tokoro10g/micromouse-vert/hardware/Mechanical/[Export]Digimode.stl

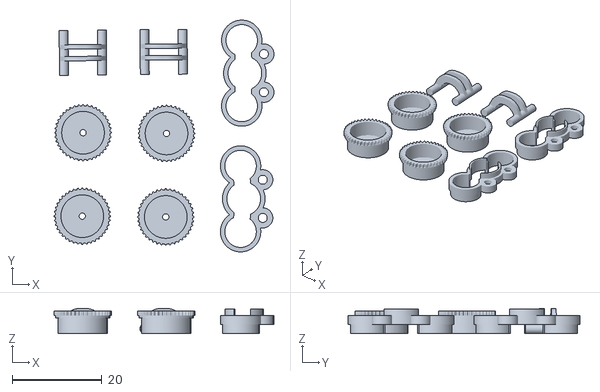
[picture p4: CAD file, 2017-10-23]
hardware/Mechanical/[Export]Digimode.stl
49.0 x 51.6 x 5.58
