tokoro10g/micromouse-vert/hardware/PCB/outline/Vert_Board.dxf

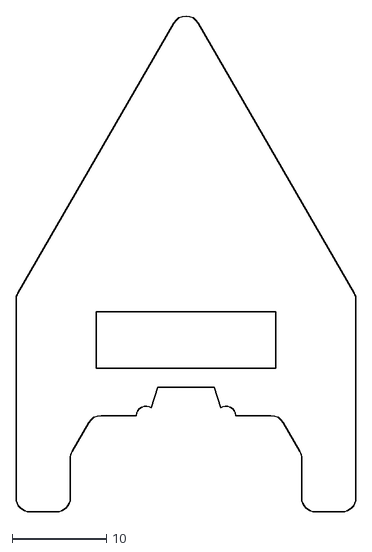
[picture p5: CAD file, 2017-10-23]
hardware/PCB/outline/Vert_Board.dxf
36.0 x 52.5
