tokoro10g/micromouse-vert/hardware/Mechanical/[Export]DMM.stl

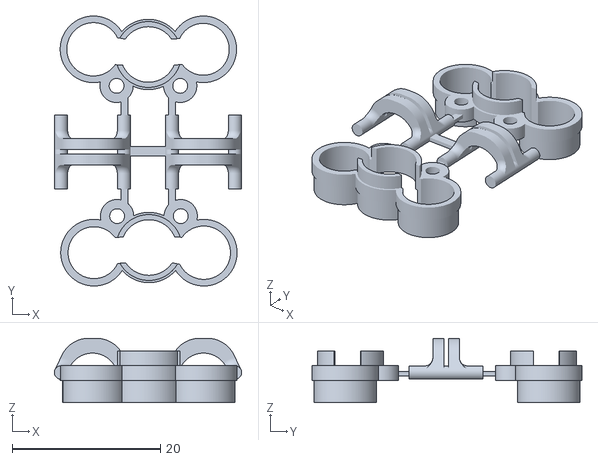
[picture p6: CAD file, 2017-10-23]
hardware/Mechanical/[Export]DMM.stl
25.3 x 36.5 x 8.70
