tokoro10g/micromouse-vert/(threads)

Thread 1 (2017-11-14):

正常に復帰できないパターンがある

tokoro10g, 2017-11-14:
6cc9f4a 時点での既知の不具合

* `Agent::searchCandidateNode`で探したノードに壁があり，かつそれが最後のCandidateNodeである場合に無限ループに陥って戻ってこない
* フェイルセーフ以外の理由(スタートからゴールまでの経路が存在しないときなど)で停止したとき，`Machine::isActivated_`の状態が解除されず，メニューに戻らない
* `Agent::searchCandidateNode`による未探索壁のチェック終了後にフェイルセーフがかかると，`backupMaze`が正常に機能しないことがある
* 探索が正常に終了しなかった後の`fastRunMode`終了後に`backupMaze`が正常に機能しないことがある

Closed 2017-11-16.
