tokoro10g/micromouse-vert/hardware/PCB/Vert_Board_rev3.kicad_pcb

## KiCad design hardware/PCB/Vert_Board_rev3.kicad_pcb (2017-10-23)

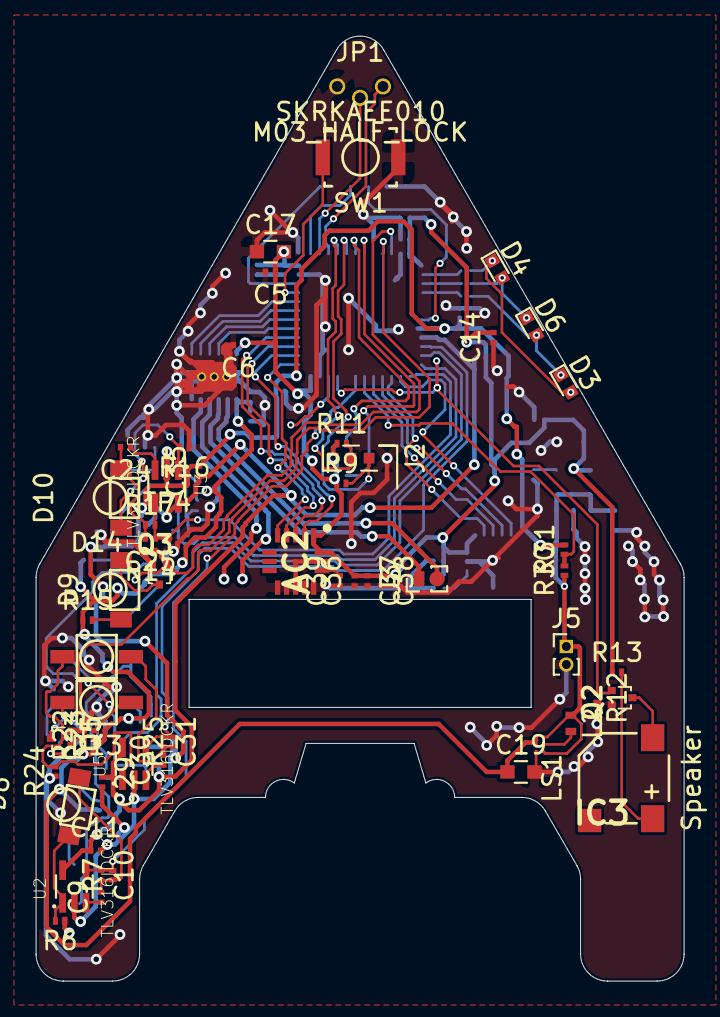
[picture p7: board Vert_Board_rev3.kicad_pcb from above]

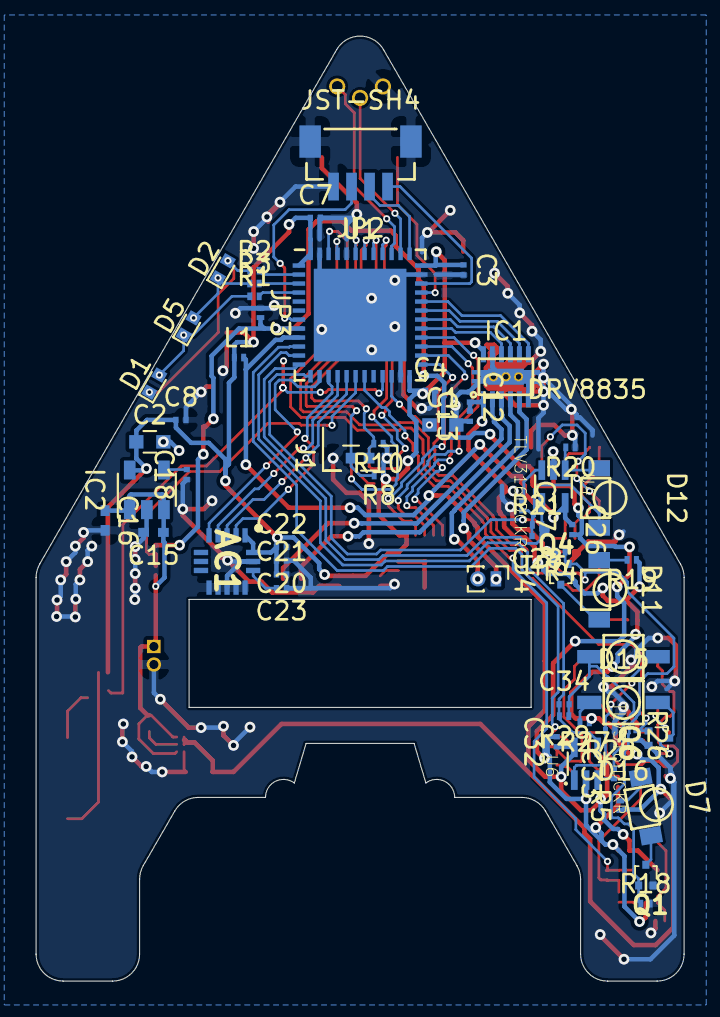
[picture p8: board Vert_Board_rev3.kicad_pcb from below]

Board: 4 copper layers, 36.0 x 52.5 mm, 117 parts (59 on the bottom side), 79 nets.

Parts:
AC1, AC2: ICM-20602; QFN50P300X300X75-16N
C1, C2, C19: 4.7u; C_0603
C3, C4, C5, C6, C7, C8, C11, C12, C14, C21, C23, C26, C29, C32, C35, C37, C39: 0.1u; C_0201_NoSilk
C9, C24, C27, C30, C33: 0.01u(NC); C_0201_NoSilk
C10, C25, C28, C31, C34: 22p; C_0201_NoSilk
C13: 22u; C_0201_NoSilk
C15: 2.2u; C_0402_NoSilk
C16: 1u; C_0402_NoSilk
C17: 10u; C_0603
C18, C20, C36: 0.01u; C_0201_NoSilk
C22, C38: 2.2u; C_0201_NoSilk
D1, D2, D3, D4, D5, D6: LED; LED_0402
D7, D9, D11: VSMB294008G; VSMB2943SL
D8, D10, D12: VEMD2020X01; VEMD2023SL
D13, D15: VSMB294008G
D14, D16: VEMD2020X01; VEMD2020
IC1: DRV8835
IC2: TAR5SB33; SOT-23-5
IC3: TPS6124x; BGA6C40P2X3_125X85X63
J1, J2: Conn_01x04; Pin_Header_Straight_1x04_Pitch1.00mm_SMD_Pin1Right
J3, J4, J5: Conn_01x02; Pin_Header_Straight_1x02_Pitch1.00mm
JP1: M03_HALF_LOCK
JP2: JST-SH4
JP3: Jumper_NC_Small; R_0201_NoSilk
L1: 10Z; R_0201_NoSilk
L2: 1u; R_0402_NoSilk
LS1: Speaker; SMT-0540-S-R
Q1, Q3, Q4, Q5, Q6: NTK3134NT1G; SOT-723
Q2: Q_NMOS_GSD; SOT-723
R1, R2, R3: 470; R_0201_NoSilk
R4, R8, R9, R10, R11, R12, R14, R18, R22, R26: 47k; R_0201_NoSilk
R5, R15, R19, R23, R27: 20; R_0201_NoSilk
R6, R16, R20, R24, R28, R30, R31: 500k; R_0201_NoSilk
R7, R17, R21, R25, R29: 1M; R_0201_NoSilk
R13: 22; R_0201_NoSilk
SW1: SKRKAEE010; ALPS-SKRK
TP4, TP6: TEST; Measurement_Point_Round-SMD-Pad_Small
U1: STM32F411CEUx; QFN-48-1EP_7x7mm_Pitch0.5mm
U2, U3, U4, U5, U6: TLV316IDCKR; SOT65P210X110-5N

Connections:
+5V: C12.2, C13.2, C19.1, IC1.1, IC3.B2, IC3.C2, R5.1, R15.1, R19.1, R23.1, R27.1
+BATT: C15.1, C16.1, IC2.1, IC2.3, IC3.A1, IC3.C1, J5.1, L2.1, R30.1
/Buzzer/BUZZER: Q2.1, R12.1, U1.21
/MCU/IMU1_MISO: AC1.4, U1.16
/MCU/IMU1_MOSI: AC1.3, U1.17
/MCU/IMU1_NSS: AC1.5, U1.14
/MCU/IMU1_SCK: AC1.2, U1.15
/MCU/IMU2_MISO: AC2.4, U1.27
/MCU/IMU2_MOSI: AC2.3, U1.28
/MCU/IMU2_NSS: AC2.5, U1.25
/MCU/IMU2_SCK: AC2.2, U1.26
/MCU/IRLED1: Q5.1, Q6.1, R22.1, R26.1, U1.45
/MCU/IRLED2: Q1.1, Q3.1, Q4.1, R4.1, R14.1, R18.1, U1.46
/MCU/MOTOR_LA: IC1.8, U1.31
/MCU/MOTOR_LB: IC1.7, U1.32
/MCU/MOTOR_RA: IC1.10, U1.29
/MCU/MOTOR_RB: IC1.9, U1.30
/MCU/NRST: JP2.2, U1.7
/MCU/SWCLK: JP2.3, U1.37
/MCU/SWDIO: JP2.4, U1.34
/MCU/UI_LED1: R2.2, U1.2
/MCU/UI_LED2: R3.2, U1.3
/MCU/UI_LED3: R1.2, U1.4
/MCU/UI_SWITCH: SW1.1, U1.33
/MCU/USART_MISO: JP1.1, U1.39
/MCU/USART_MOSI: JP1.2, U1.38
/Motor_L/ENCLA: J2.3, R11.2, U1.40
/Motor_L/ENCLB: J2.2, R9.2, U1.41
/Motor_L/ENCRA: J1.2, R8.2, U1.43
/Motor_L/ENCRB: J1.3, R10.2, U1.42
/OpticalSensor_FRONT/IR_SENS: C10.1, R7.2, U1.19, U2.4
/OpticalSensor_IRLB/IR_SENS: C25.1, R17.2, TP4.1, U1.13, U3.4
/OpticalSensor_IRLF/IR_SENS: C34.1, R29.2, U1.11, U6.4
/OpticalSensor_IRRB/IR_SENS: C28.1, R21.2, TP6.1, U1.12, U4.4
/OpticalSensor_IRRF/IR_SENS: C31.1, R25.2, U1.10, U5.4
GND: AC1.9, AC1.10, AC1.11, AC1.12, AC1.13, AC1.15, AC2.9, AC2.10, AC2.11, AC2.12, AC2.13, AC2.15, C1.2, C2.2, C3.2, C4.2, C5.2, C6.2, C7.2, C8.2, C12.1, C13.1, C14.1, C15.2, C16.2, C17.1, C18.1, C19.2, C20.1, C21.2, C22.2, C23.1, C36.1, C37.2, C38.2, C39.1, IC1.0, IC1.6, IC1.11, IC2.2, IC3.A2, J1.1, J2.1, J5.2, JP1.3, JP2.0, JP2.1, JP3.1, Q1.2, Q2.2, Q3.2, Q4.2, Q5.2, Q6.2, R4.2, R6.1, R12.2, R14.2, R16.1, R18.2, R20.1, R22.2, R24.1, R26.2, R28.1, SW1.2, U1.23, U1.35, U1.44, U1.47, U1.49
GNDA: C11.2, C26.2, C29.2, C32.2, C35.2, JP3.2, R31.2, U1.8, U2.2, U3.2, U4.2, U5.2, U6.2
unnamed: AC1.14, C23.2
unnamed: AC2.14, C39.2
unnamed: C1.1, U1.22
unnamed: C9.1, U2.3
unnamed: C9.2, C10.2, D8.2, R7.1
unnamed: C18.2, IC2.4
unnamed: C24.1, U3.3
unnamed: C24.2, C25.2, D10.2, R17.1
unnamed: C27.1, U4.3
unnamed: C27.2, C28.2, D12.2, R21.1
unnamed: C30.1, U5.3
unnamed: C30.2, C31.2, D14.2, R25.1
unnamed: C33.1, U6.3
unnamed: C33.2, C34.2, D16.2, R29.1
unnamed: D1.1, D2.2, D3.2, D4.1, R2.1
unnamed: D1.2, D3.1, D5.1, D6.2, R1.1
unnamed: D2.1, D4.2, D5.2, D6.1, R3.1
unnamed: D7.1, Q1.3
unnamed: D7.2, R5.2
unnamed: D8.1, R6.2, U2.1
unnamed: D9.1, Q3.3
unnamed: D9.2, R15.2
unnamed: D10.1, R16.2, U3.1
unnamed: D11.1, Q4.3
unnamed: D11.2, R19.2
unnamed: D12.1, R20.2, U4.1
unnamed: D13.1, Q5.3
unnamed: D13.2, R23.2
unnamed: D14.1, R24.2, U5.1
unnamed: D15.1, Q6.3
unnamed: D15.2, R27.2
unnamed: D16.1, R28.2, U6.1
unnamed: IC1.2, J3.2
unnamed: IC1.3, J3.1
unnamed: IC1.4, J4.2
unnamed: IC1.5, J4.1
unnamed: IC3.B1, L2.2
unnamed: LS1.1, R13.2
unnamed: LS1.2, Q2.3
unnamed: R30.2, R31.1, U1.18
VDD: AC1.1, AC1.16, AC2.1, AC2.16, C2.1, C3.1, C4.1, C5.1, C6.1, C7.1, C8.1, C14.2, C17.2, C20.2, C21.1, C22.1, C36.2, C37.1, C38.1, IC1.12, IC2.5, J1.4, J2.4, L1.1, R8.1, R9.1, R10.1, R11.1, R13.1, U1.1, U1.24, U1.36, U1.48
VDDA: C11.1, C26.1, C29.1, C32.1, C35.1, L1.2, U1.9, U2.5, U3.5, U4.5, U5.5, U6.5
