tokoro10g/micromouse-vert/src/vert_firmware/autogen/vert_firmware.ioc

Mcu.UserName=STM32F411CEUx
PA0-WKUP.Signal=ADCx_IN0
PA1.Signal=ADCx_IN1
PA10.GPIO_Label=MOTOR_LA
PA10.Signal=S_TIM1_CH3
PA11.GPIO_Label=MOTOR_LB
PA11.Signal=S_TIM1_CH4
PA12.GPIO_Label=GPIO_IN_Button
PA12.Signal=GPIO_Input
PA13.Signal=SYS_JTMS-SWDIO
PA14.Signal=SYS_JTCK-SWCLK
PA15.Signal=USART1_TX
PA2.Signal=ADCx_IN2
PA3.Signal=ADCx_IN3
PA4.Signal=SPI1_NSS
PA5.Signal=SPI1_SCK
PA6.Signal=SPI1_MISO
PA7.Signal=SPI1_MOSI
PA8.GPIO_Label=MOTOR_RA
PA8.Signal=S_TIM1_CH1
PA9.GPIO_Label=MOTOR_RB
PA9.Signal=S_TIM1_CH2
PB0.Signal=ADCx_IN8
PB1.Signal=ADCx_IN9
PB10.GPIO_Label=TIM2_CH3_Buzzer
PB10.Signal=S_TIM2_CH3
PB12.Signal=SPI2_NSS
PB13.Signal=SPI2_SCK
PB14.Signal=SPI2_MISO
PB15.Signal=SPI2_MOSI
PB3.Signal=USART1_RX
PB4.Signal=S_TIM3_CH1
PB5.Signal=S_TIM3_CH2
PB6.Signal=S_TIM4_CH1
PB7.Signal=S_TIM4_CH2
PB8.GPIO_Label=IRLED1
PB8.Signal=S_TIM10_CH1
PB9.GPIO_Label=IRLED2
PB9.Signal=S_TIM11_CH1
PC13-ANTI_TAMP.Signal=GPIO_Output
PC14-OSC32_IN.Signal=GPIO_Output
PC15-OSC32_OUT.Signal=GPIO_Output
