tokoro10g/micromouse-vert/src/vert_firmware/autogen/Inc/main.h

#define TIM2_CH3_Buzzer_Pin GPIO_PIN_10
#define TIM2_CH3_Buzzer_GPIO_Port GPIOB
#define MOTOR_RA_Pin GPIO_PIN_8
#define MOTOR_RA_GPIO_Port GPIOA
#define MOTOR_RB_Pin GPIO_PIN_9
#define MOTOR_RB_GPIO_Port GPIOA
#define MOTOR_LA_Pin GPIO_PIN_10
#define MOTOR_LA_GPIO_Port GPIOA
#define MOTOR_LB_Pin GPIO_PIN_11
#define MOTOR_LB_GPIO_Port GPIOA
#define GPIO_IN_Button_Pin GPIO_PIN_12
#define GPIO_IN_Button_GPIO_Port GPIOA
#define IRLED1_Pin GPIO_PIN_8
#define IRLED1_GPIO_Port GPIOB
#define IRLED2_Pin GPIO_PIN_9
#define IRLED2_GPIO_Port GPIOB
