tokoro10g/micromouse-vert/src/mymath/mymath.h

#pragma once

namespace MyMath {
	const float PI = 3.1415927f;
	const uint32_t FAST_MATH_TABLE_SIZE = 512;

	/**   
	 * \par    
	 * Example code for the generation of the floating-point sine table:
	 * <pre>
	 * tableSize = 512;    
	 * for(n = 0; n < (tableSize + 1); n++)    
	 * {    
	 *	sinTable[n]=sin(2*pi*n/tableSize);    
	 * }</pre>    
	 * \par    
	 * where pi value is  3.14159265358979    
	 */

	static const float sinTable_f32[513] = {
		0.00000000f, 0.01227154f, 0.02454123f, 0.03680722f, 0.04906767f, 0.06132074f,
		0.07356456f, 0.08579731f, 0.09801714f, 0.11022221f, 0.12241068f, 0.13458071f,
		0.14673047f, 0.15885814f, 0.17096189f, 0.18303989f, 0.19509032f, 0.20711138f,
		0.21910124f, 0.23105811f, 0.24298018f, 0.25486566f, 0.26671276f, 0.27851969f,
		0.29028468f, 0.30200595f, 0.31368174f, 0.32531029f, 0.33688985f, 0.34841868f,
		0.35989504f, 0.37131719f, 0.38268343f, 0.39399204f, 0.40524131f, 0.41642956f,
		0.42755509f, 0.43861624f, 0.44961133f, 0.46053871f, 0.47139674f, 0.48218377f,
		0.49289819f, 0.50353838f, 0.51410274f, 0.52458968f, 0.53499762f, 0.54532499f,
		0.55557023f, 0.56573181f, 0.57580819f, 0.58579786f, 0.59569930f, 0.60551104f,
		0.61523159f, 0.62485949f, 0.63439328f, 0.64383154f, 0.65317284f, 0.66241578f,
		0.67155895f, 0.68060100f, 0.68954054f, 0.69837625f, 0.70710678f, 0.71573083f,
		0.72424708f, 0.73265427f, 0.74095113f, 0.74913639f, 0.75720885f, 0.76516727f,
		0.77301045f, 0.78073723f, 0.78834643f, 0.79583690f, 0.80320753f, 0.81045720f,
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
		while(x>a){ x-=T(2)*a; }
		while(x<=-a){ x+=T(2)*a; }
	}

	template<typename T> T normalized(T x, T a){
		T y=x; normalize(y,a);
		return y;
	}

	template<typename T> T squared(T x){
		return x*x;
	}

	template<typename T> T signof(T val){
		return (T(0)<val)-(val<T(0));
	}
}
