tokoro10g/micromouse-vert/src/vert_firmware/machine/globals.cpp

#include "encoder.h"
#include "buzzer.h"
#include "button.h"
#include "flash.h"
#include "leds.h"
#include "motors.h"
#include "imu.h"
#include "irsensor.h"
#include "irled.h"

Vert::Encoder encoderL(TIM3);
Vert::Encoder encoderR(TIM4);

Vert::Flash flash;

Vert::Buzzer buzzer;
Vert::Button button;
Vert::LEDs leds;
Vert::Motors motors;
Vert::IMU imu1(SPI1, GPIOA, GPIO_PIN_4);
Vert::IMU imu2(SPI2, GPIOB, GPIO_PIN_12);

Vert::IRSensor irsensor;
Vert::IRLED irled1(TIM10);
Vert::IRLED irled2(TIM11);
