tokoro10g/micromouse-vert/(commit log)

2017-10-29 壁センサまわり実装中
2017-10-29 制御用コードのインポート，floatをprintできるように
2017-11-06 軌道キュー・UIを移植，軌道追従の基本機能の動作を確認
2017-11-06 addし忘れ…
2017-11-11 探索・最短走行を実装．壁トレース制御を調整中．
2017-11-14 クラシックサイズモード・クォーターサイズモードを実装．センサのキャリブレーション等も完了．
2017-11-15 軽微な不具合の修正
2017-11-16 探索・メニューまわりのバグ修正 fixes #1.
2017-11-16 最適化でIRLEDの動作が消えることがあるのを修正
2017-11-16 迷路端で既知区間加速が起こらないバグを修正．1マスの場合に加速しないように変更．
2017-11-16 センシング前の距離パラメータを追加 [experimental]
2017-11-16 迷路ダンプモードを追加．その他雑多な変更．
2017-11-16 壁パラメータ暫定
2018-08-19 ブザーの音量変更機能を追加
2018-08-19 迷路情報をFLASHに読み書きする機能を追加
2018-08-19 メロディとデバッグ用のブザー音を追加
2018-08-19 サーキットモードを追加(注:迷路サイズベタ書き)
2018-08-19 サーキットモードのデバッグ用のシーケンスを追加
2018-08-19 ターン前の距離を調整
2018-08-19 機体パラメータの調整
2018-08-19 走行パラメータの調整
2018-08-19 機体の制御に使用するパラメータの調整
2018-08-19 壁センサまわりの補正コードを変更
2018-08-19 バグった挙動をひとまず治すためだけのコード(後で解決する)
2018-08-19 雑多なもの
2018-08-19 ビルドの潜在的な不具合を解消
2018-08-19 clangのlanguage serverに読ませるためのファイルを作成
2018-08-19 libmazesolverの更新
