tokoro10g/micromouse-vert/(notices)

Notices in the files:
src/vert_firmware/autogen/Inc/main.h:
COPYRIGHT(c) 2017 STMicroelectronics
(C) COPYRIGHT STMicroelectronics *****END OF FILE
